jalambert98/WCSA_SDP_2022/Hardware/WCSA_OrCAD/WCSA_SystemSchem/README.txt

Copy/paste contents of "/Footprints" folder (but not folder itself)
into --> "C:\Cadence\SPB_17.4\share\pcb\pcb_lib\symbols"

AND / OR

Add the complete filepath of the "/Footprints" folder into the
'psmpath' variable within Allegro's user preferences
