jalambert98/WCSA_SDP_2022/Hardware/WCSA_OrCAD/JLC_BoardPics/3D-View/3D-04-TopAngleWhole.png

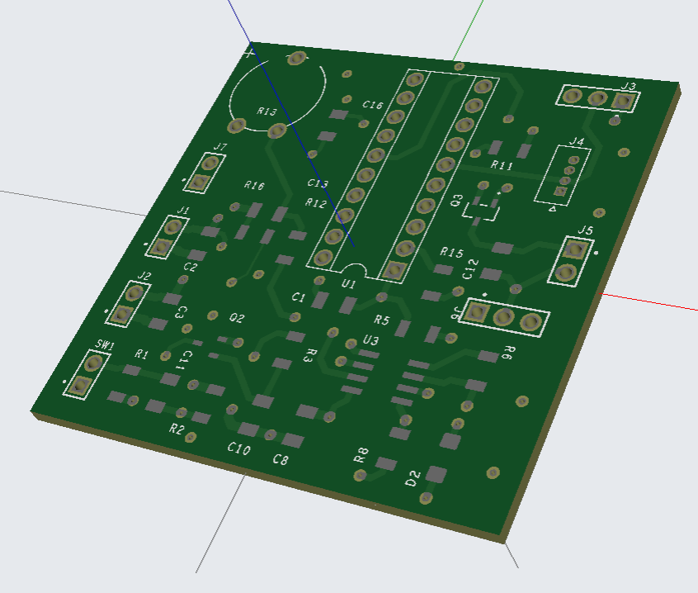
Hardware/WCSA_OrCAD/JLC_BoardPics/3D-View/3D-04-TopAngleWhole.png
