jalambert98/WCSA_SDP_2022/Hardware/WCSA_OrCAD/JLC_BoardPics/LayerView/01-Top_SMSS.png

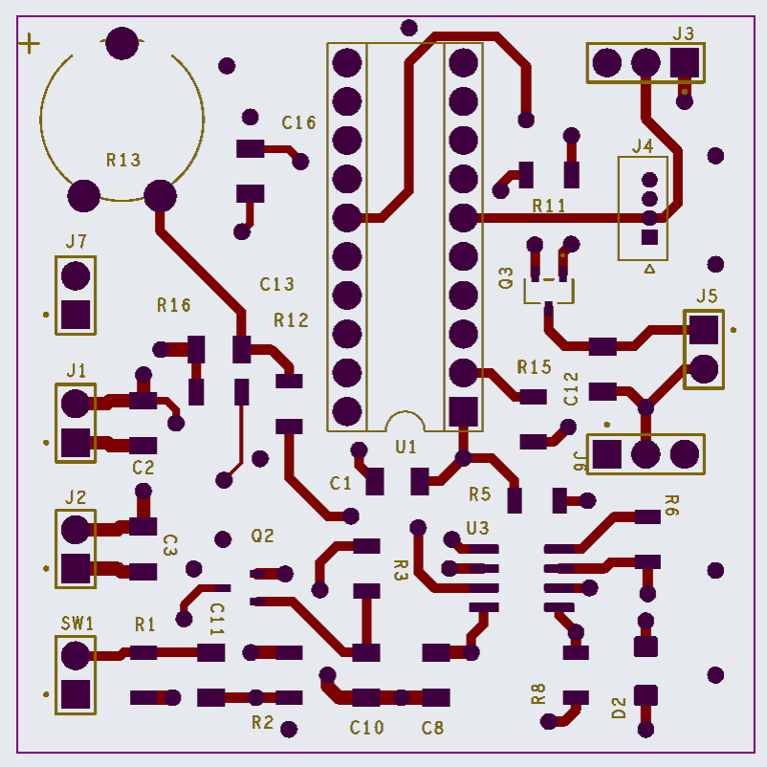
Hardware/WCSA_OrCAD/JLC_BoardPics/LayerView/01-Top_SMSS.png
