jalambert98/WCSA_SDP_2022/Hardware/WCSA_OrCAD/JLC_BoardPics/LayerView/02-GND_In1.png

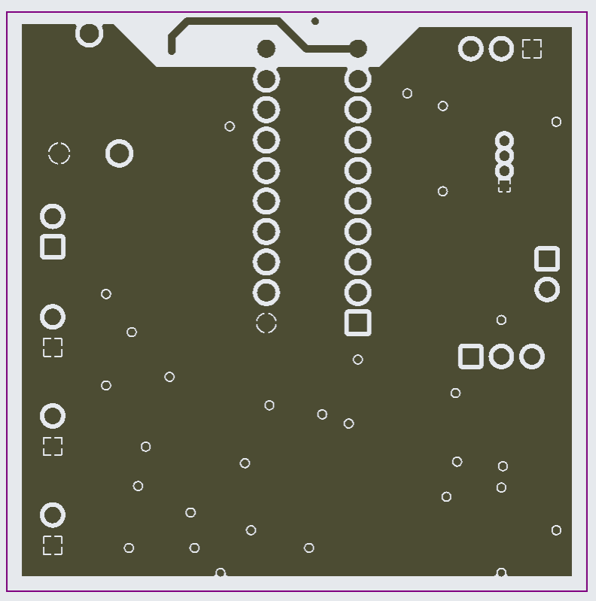
Hardware/WCSA_OrCAD/JLC_BoardPics/LayerView/02-GND_In1.png
