jalambert98/WCSA_SDP_2022/Hardware/WCSA_OrCAD/JLC_BoardPics/LayerView/03-DCV_In2.png

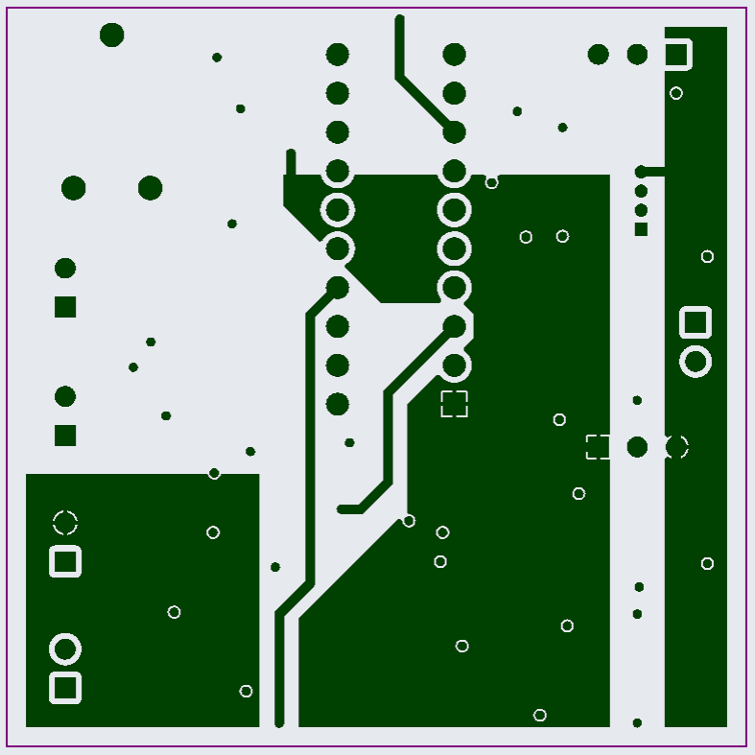
Hardware/WCSA_OrCAD/JLC_BoardPics/LayerView/03-DCV_In2.png
