jalambert98/WCSA_SDP_2022/Hardware/WCSA_OrCAD/JLC_BoardPics/ProductionPCB/LidarHeader_Footprint.jpg

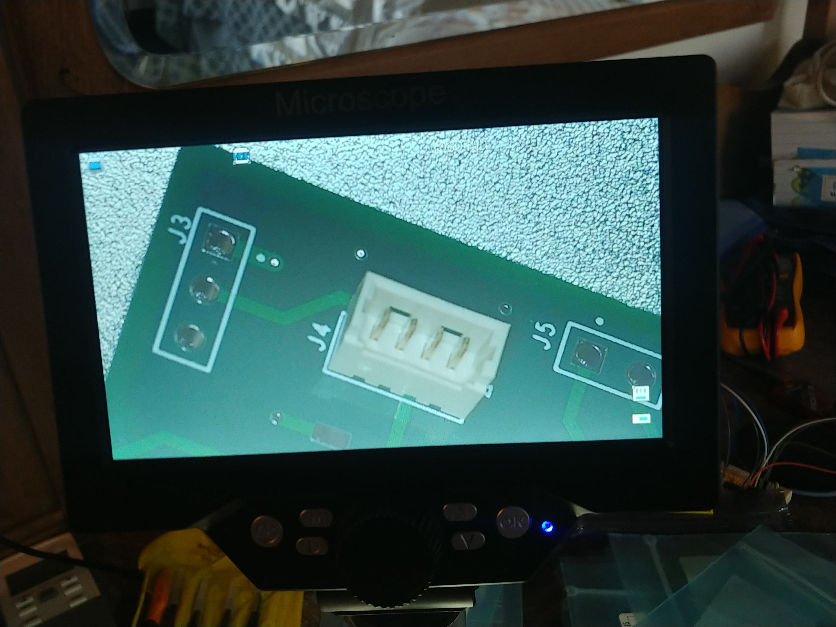
Hardware/WCSA_OrCAD/JLC_BoardPics/ProductionPCB/LidarHeader_Footprint.jpg
