jalambert98/WCSA_SDP_2022/Hardware/WCSA_OrCAD/JLC_BoardPics/ProductionPCB/PMIC_Footprint-Empty.jpg

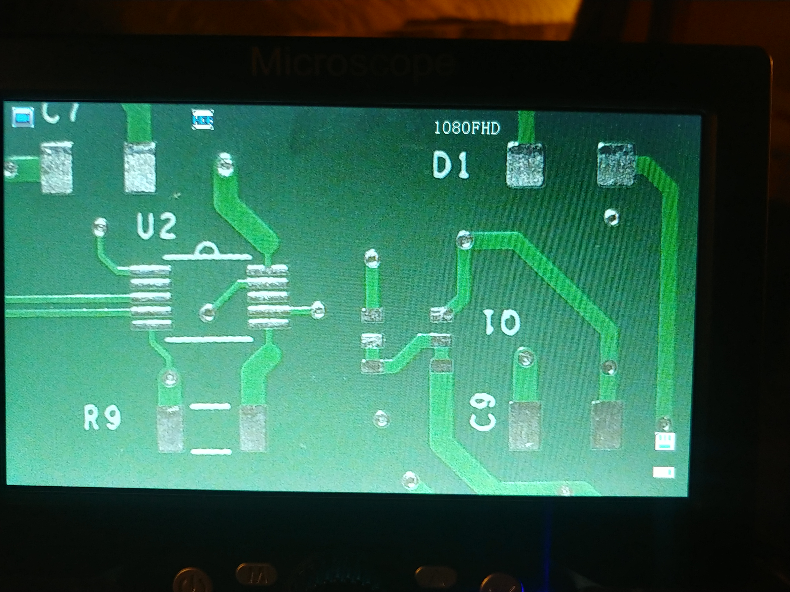
Hardware/WCSA_OrCAD/JLC_BoardPics/ProductionPCB/PMIC_Footprint-Empty.jpg
