jalambert98/WCSA_SDP_2022/Hardware/WCSA_OrCAD/PSPICE/MCU_PowerButton_Simulation/MCU_POWER_BUTTON.png

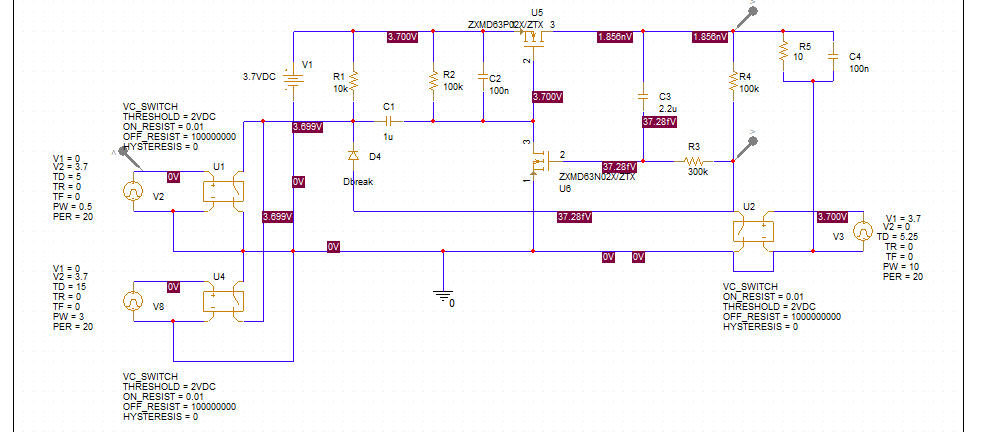
Hardware/WCSA_OrCAD/PSPICE/MCU_PowerButton_Simulation/MCU_POWER_BUTTON.png
