jalambert98/WCSA_SDP_2022/Hardware/WCSA_OrCAD/PSPICE/PowerSystem_Simulations/POWERSYSTEM_SIMULATIONS.png

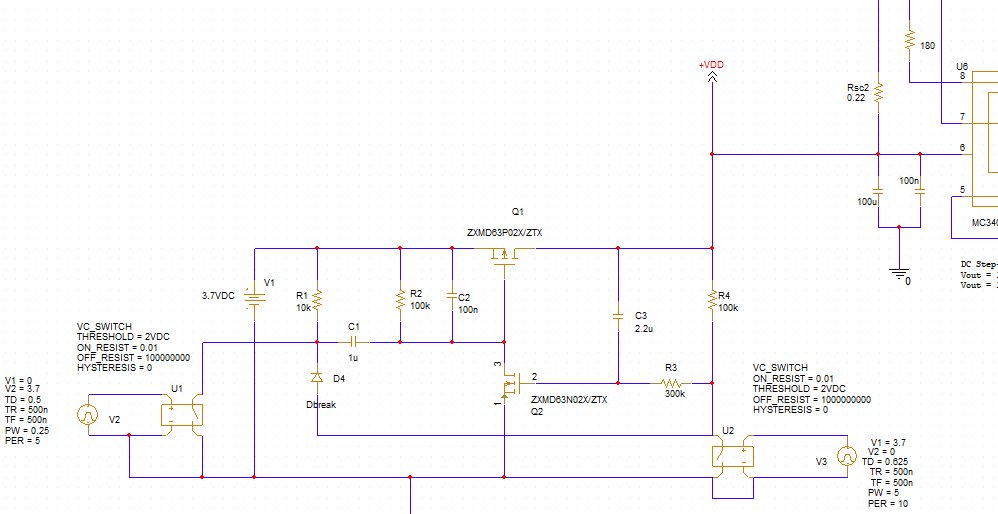
Hardware/WCSA_OrCAD/PSPICE/PowerSystem_Simulations/POWERSYSTEM_SIMULATIONS.png
