jalambert98/WCSA_SDP_2022/Hardware/WCSA_OrCAD/WCSA_SystemSchem/WCSA_SYSTEMSCHEM.png

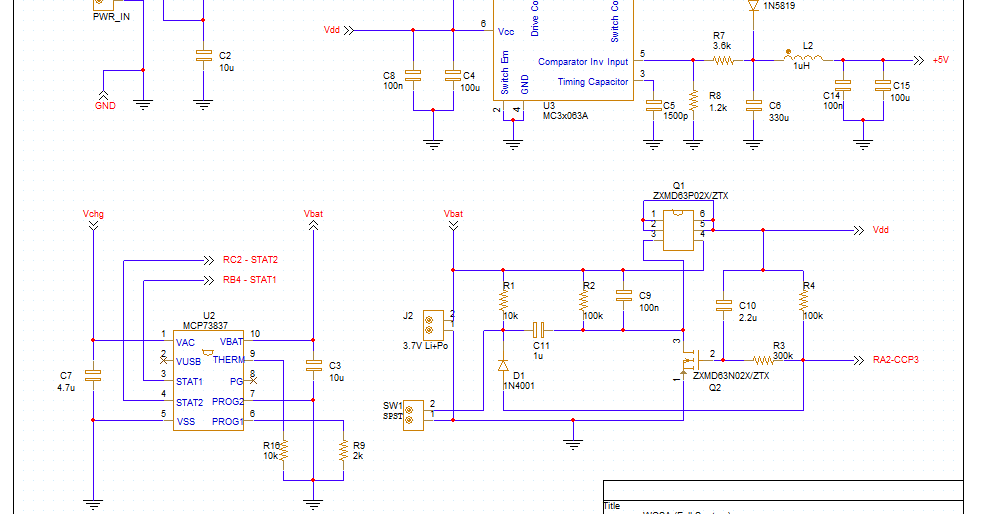
Hardware/WCSA_OrCAD/WCSA_SystemSchem/WCSA_SYSTEMSCHEM.png
