jalambert98/WCSA_SDP_2022/Hardware/SolidWorks_Assembly/CaneWithClamps.SLDASM

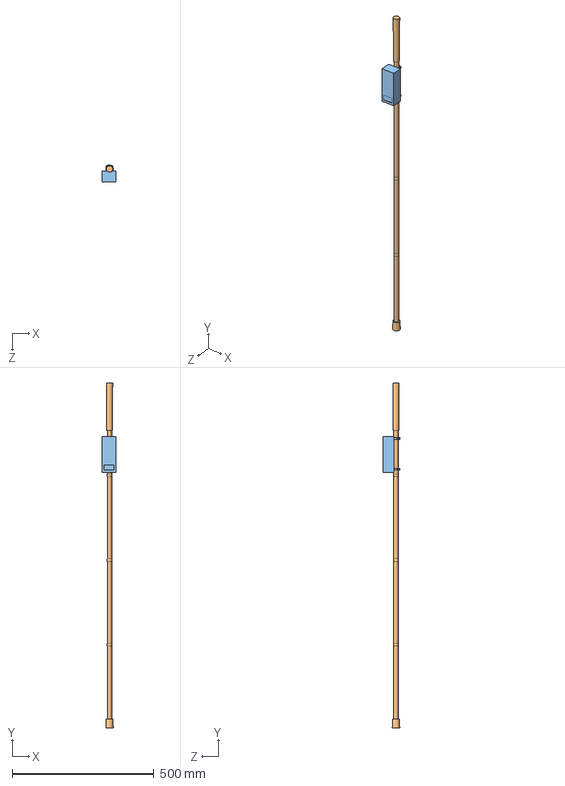
[picture p20: CAD file, 2022-04-21]
Hardware/SolidWorks_Assembly/CaneWithClamps.SLDASM
50.6 x 1216.0 x 59.4 mm
3dCaneRev1.05
HoseClamp x 2
Housing Rev0.5
