jalambert98/WCSA_SDP_2022/Hardware/SolidWorks_Assembly/LidSmSpeaker_V5.0.SLDPRT

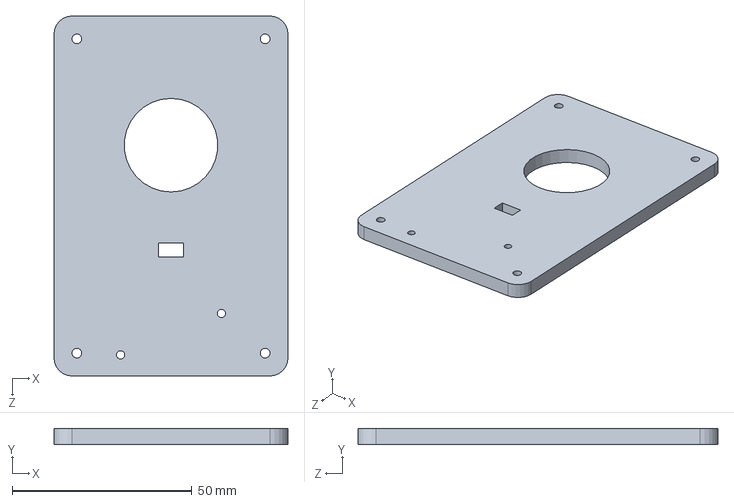
[picture p21: CAD file, 2022-05-31]
Hardware/SolidWorks_Assembly/LidSmSpeaker_V5.0.SLDPRT
65.0 x 4.50 x 100.0 mm
