jalambert98/WCSA_SDP_2022/Hardware/SolidWorks_Assembly/HousingBox_V5.0.SLDPRT

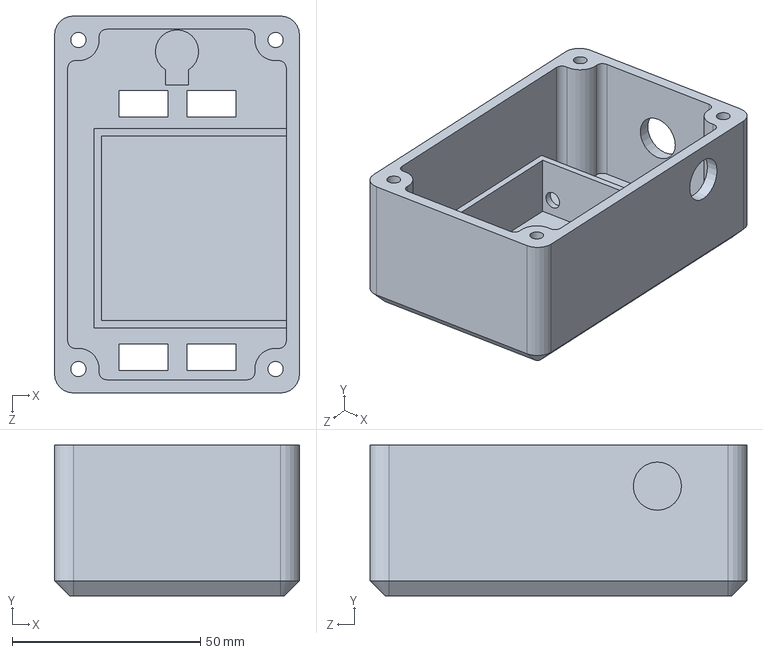
[picture p22: CAD file, 2022-05-31]
Hardware/SolidWorks_Assembly/HousingBox_V5.0.SLDPRT
65.0 x 40.0 x 100.0 mm
