jalambert98/WCSA_SDP_2022/Hardware/SolidWorks_Assembly/HoseClamp.SLDPRT

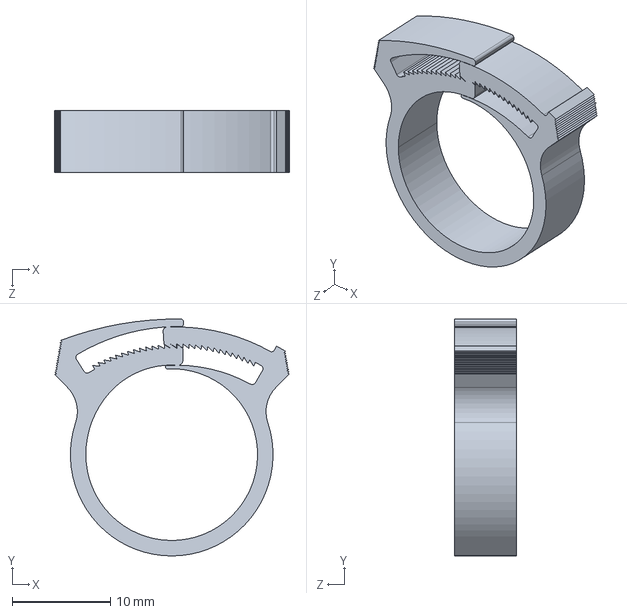
[picture p23: CAD file, 2022-04-21]
Hardware/SolidWorks_Assembly/HoseClamp.SLDPRT
23.9 x 24.1 x 6.35 mm
