jalambert98/WCSA_SDP_2022/Hardware/SolidWorks_Assembly/3dCaneRev1.05.SLDPRT

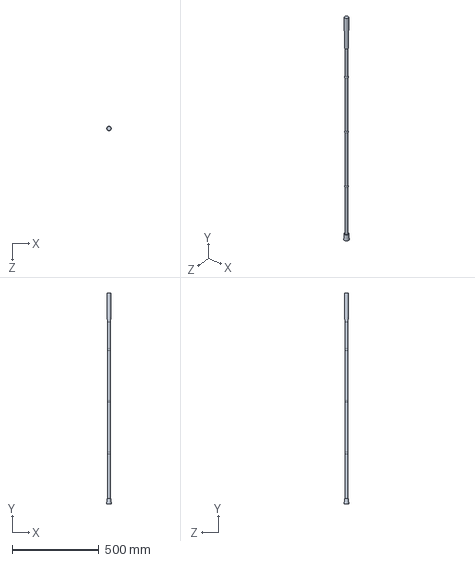
[picture p24: CAD file, 2022-04-21]
Hardware/SolidWorks_Assembly/3dCaneRev1.05.SLDPRT
26.8 x 1216.0 x 26.8 mm
