jalambert98/WCSA_SDP_2022/Hardware/SolidWorks_Assembly/Housing_Rev0.5.SLDPRT

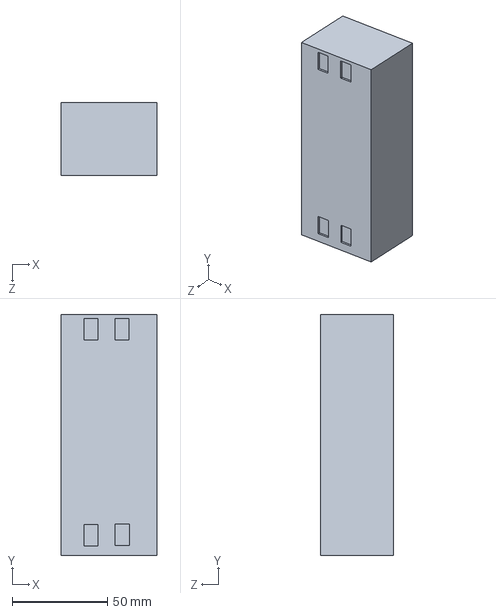
[picture p25: CAD file, 2022-04-21]
Hardware/SolidWorks_Assembly/Housing_Rev0.5.SLDPRT
50.6 x 126.8 x 38.4 mm
