jalambert98/WCSA_SDP_2022/(list of files, cad)

Other CAD files:
Hardware/WCSA_OrCAD/WCSA_SystemSchem/Footprints/capc3216x110n.psm
Hardware/WCSA_OrCAD/WCSA_SystemSchem/Footprints/diosc190x340x116-2n.psm
Hardware/WCSA_OrCAD/WCSA_SystemSchem/Footprints/dip-20-socket.psm
Hardware/WCSA_OrCAD/WCSA_SystemSchem/Footprints/ind_smt_do3316p_12p95x9p4_coc.psm
Hardware/WCSA_OrCAD/WCSA_SystemSchem/Footprints/indc3216x95n.psm
Hardware/WCSA_OrCAD/WCSA_SystemSchem/Footprints/molex_530470410.psm
Hardware/WCSA_OrCAD/WCSA_SystemSchem/Footprints/mub10a-l.psm
Hardware/WCSA_OrCAD/WCSA_SystemSchem/Footprints/mub10a-m.psm
Hardware/WCSA_OrCAD/WCSA_SystemSchem/Footprints/mub10a.psm
Hardware/WCSA_OrCAD/WCSA_SystemSchem/Footprints/resc3116x65n.psm
Hardware/WCSA_OrCAD/WCSA_SystemSchem/Footprints/samtec_mtsw-101-08-s-d-315.psm
Hardware/WCSA_OrCAD/WCSA_SystemSchem/Footprints/samtec_tsw-101-24-g-t.psm
Hardware/WCSA_OrCAD/WCSA_SystemSchem/Footprints/soic127p599x175-8n.psm
Hardware/WCSA_OrCAD/WCSA_SystemSchem/Footprints/sop50p490x110-10n.psm
Hardware/WCSA_OrCAD/WCSA_SystemSchem/Footprints/sot23_2p9x1p3_dio-l.psm
Hardware/WCSA_OrCAD/WCSA_SystemSchem/Footprints/sot23_2p9x1p3_dio-m.psm
Hardware/WCSA_OrCAD/WCSA_SystemSchem/Footprints/sot23_2p9x1p3_dio.psm
Hardware/WCSA_OrCAD/WCSA_SystemSchem/Footprints/to_-102a2020-s_phr.psm
Hardware/WCSA_OrCAD/WCSA_SystemSchem/Footprints/zxm62p02e6ta_dio-l.psm
Hardware/WCSA_OrCAD/WCSA_SystemSchem/Footprints/zxm62p02e6ta_dio-m.psm
Hardware/WCSA_OrCAD/WCSA_SystemSchem/Footprints/zxm62p02e6ta_dio.psm
