jalambert98/WCSA_SDP_2022/Hardware/WCSA_OrCAD/Schematic PDFs/MCUcomms_WCSA.pdf

UART Monitoring | LiDAR Sensor

## Microcontroller

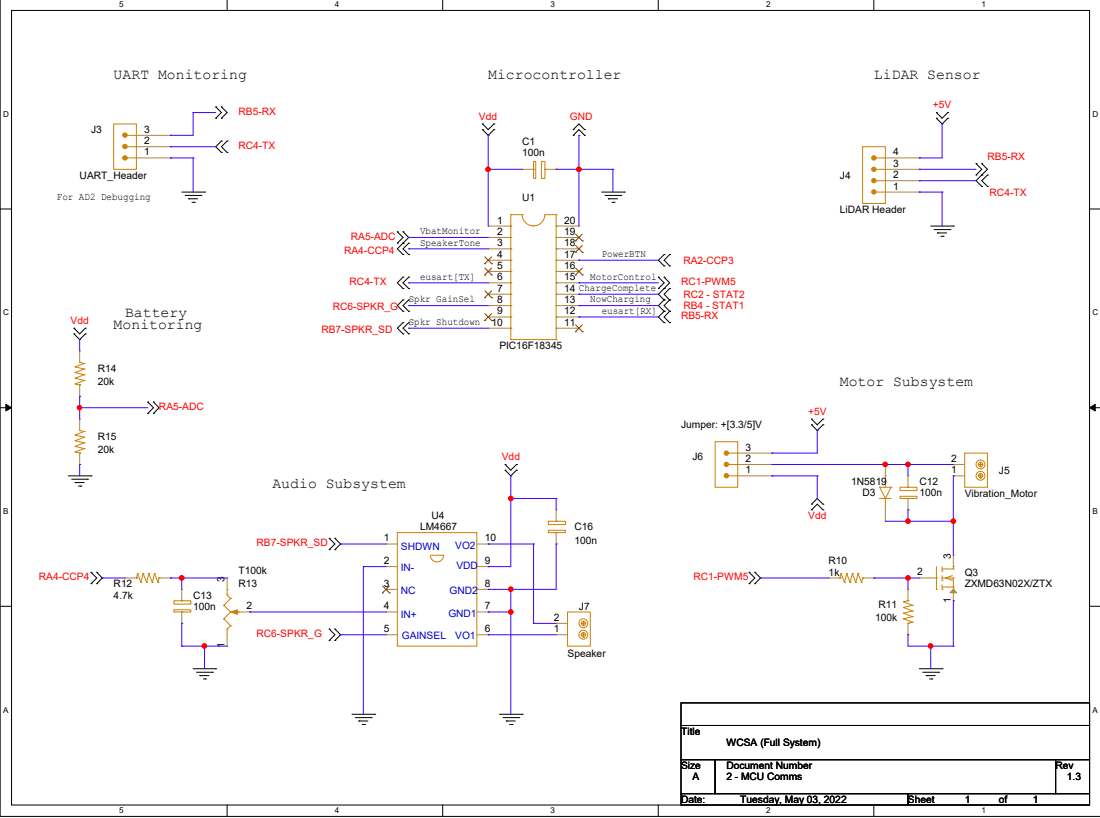
[picture p26: page 1]
