jalambert98/WCSA_SDP_2022/Hardware/WCSA_OrCAD/Schematic PDFs/PowerSubsystem_WCSA.pdf

## Charging Input

## +5VDC Voltage Regulation

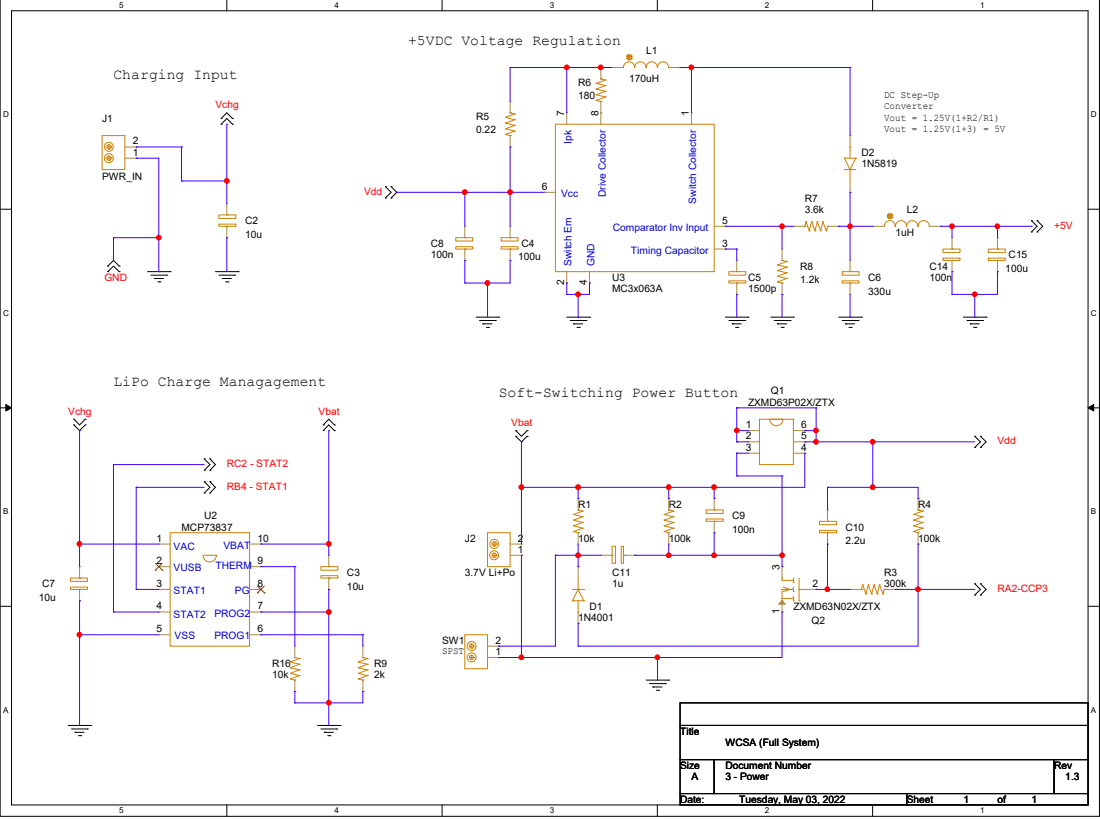
[picture p27: page 1]

Soft-Switching Power Button
