jalambert98/WCSA_SDP_2022/Hardware/WCSA_OrCAD/Schematic PDFs/PSPICE_Testing_PowerSubsystem_WCSA.pdf

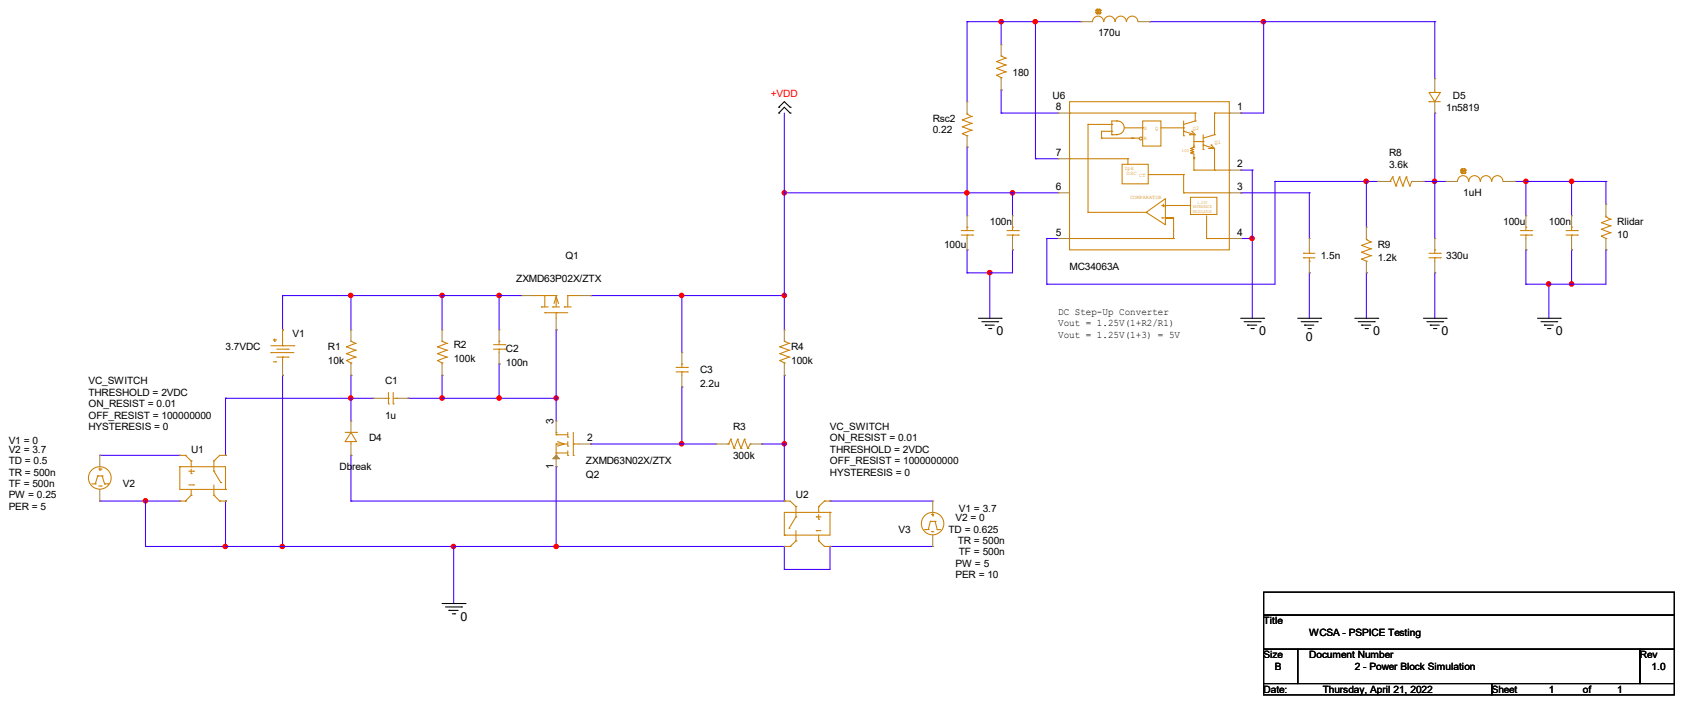
[picture p28: page 1]

DC Step-Up Converter
Vout = 1.25V(1+R2/R1)
Vout = 1.25V(1+3) = 5V
