jalambert98/WCSA_SDP_2022/(list of files, drawings)

Other design files:
Hardware/WCSA_OrCAD/PSPICE/MCU_PowerButton_Simulation/MCU_POWER_BUTTON.DSN
Hardware/WCSA_OrCAD/PSPICE/MCU_PowerButton_Simulation/MCU_Power_Button.opj
Hardware/WCSA_OrCAD/PSPICE/PowerSystem_Simulations/PowerSystem_Simulations-PSpiceFiles/SCHEMATIC1/PowerBlock_Sim/SLLM359/MC33063A-Q1_PSPICE_TRANS/MC33063A-Q1_TRANS.OPJ
Hardware/WCSA_OrCAD/PSPICE/PowerSystem_Simulations/PowerSystem_Simulations-PSpiceFiles/SCHEMATIC1/PowerBlock_Sim/SLLM359/MC33063A-Q1_PSPICE_TRANS/MC33063A-Q1D_TRANS.OLB
Hardware/WCSA_OrCAD/PSPICE/PowerSystem_Simulations/POWERSYSTEM_SIMULATIONS.DSN
Hardware/WCSA_OrCAD/PSPICE/PowerSystem_Simulations/PowerSystem_Simulations.opj
Hardware/WCSA_OrCAD/WCSA_SystemSchem/WCSA_SYSTEMSCHEM.DSN
Hardware/WCSA_OrCAD/WCSA_SystemSchem/WCSA_SystemSchem.opj
