jalambert98/WCSA_SDP_2022/Current Software Release/curr_src/Lidar_Sensor.c

/* 
 * File:    Lidar_Sensor.c
 * Author:  Jack Lambert     <joalambe@ucsc.edu>
 * Project: WCSA_SDP_2022
 *
 * Created on March 4th, 2022 at 8:25PM
 */
//------------------------------------------------------------------------------

#include "Lidar_Sensor.h"
#include "eusart.h"
#include "pin_manager.h"


//==============================================================================
//-------------------------------- #DEFINES ------------------------------------
//==============================================================================

// #define LIDAR_SENSOR_TEST


//==============================================================================
//---------------------------- STATIC VARIABLES --------------------------------
//==============================================================================

static volatile Lidar_MsgRX_t currMsg;
static volatile Lidar_StateRX_t currState;
static volatile uint8_t msgIndex;


//==============================================================================
//------------------------------ PUBLIC LIBRARY --------------------------------
//==============================================================================

void Lidar_Sensor_Init(void) {
    // Set RX State Machine to IDLE state
    currState = IDLE;

    // Initialize all MsgRX variables to zero
    uint8_t i;
    for (i = 0; i < LIDAR_RX_MSG_LEN; i++) {
        currMsg.data[i] = 0;
    }
    currMsg.distance = 0;
    currMsg.strength = 0;
    currMsg.temp = 0;
    currMsg.checksum = 0;
    msgIndex = 0;
}

//------------------------------------------------------------------------------

void Lidar_Sensor_UpdateChecksum(void) {
    uint8_t i;
    currMsg.checksum = 0;

    for (i = 0; i < (LIDAR_RX_MSG_LEN - 1); i++) {
        currMsg.checksum += currMsg.data[i];
    }

    return;
}

//------------------------------------------------------------------------------

void Lidar_Sensor_RXSM(uint8_t ch) {
    switch (currState) {
        case IDLE: // index[0]
            if (ch == LIDAR_RX_FRAMEHEADER) {
                currMsg.data[msgIndex] = ch;
                currState = W4_HEADER_2;
                msgIndex++; // --> [1]
            }
            // otherwise, do nothing (remain in IDLE)
            break;

        case W4_HEADER_2: // index[1]
            if (ch == LIDAR_RX_FRAMEHEADER) {
                currMsg.data[msgIndex] = ch;
                currState = W4_DIST_L;
                msgIndex++; // --> [2]
            } else {
                // Reset RX State Machine if incorrect header byte
                currState = IDLE;
                msgIndex = 0;
            }
            break;

        case W4_DIST_L: // index[2]
            currMsg.data[msgIndex] = ch;
            currState = W4_DIST_H;
            msgIndex++; // --> [3]
            break;

        case W4_DIST_H: // index[3]
            currMsg.data[msgIndex] = ch;
            currState = W4_STRENGTH_L;
            msgIndex++; // --> [4]
            break;

        case W4_STRENGTH_L: // index[4]
            currMsg.data[msgIndex] = ch;
            currState = W4_STRENGTH_H;
            msgIndex++; // --> [5]
            break;

        case W4_STRENGTH_H: // index[5]
            currMsg.data[msgIndex] = ch;
            currState = W4_TEMP_L;
            msgIndex++; // --> [6]
            break;

        case W4_TEMP_L: // index[6]
            currMsg.data[msgIndex] = ch;
            currState = W4_TEMP_H;
            msgIndex++; // --> [7]
            break;

        case W4_TEMP_H: // index[7]
            currMsg.data[msgIndex] = ch;
            currState = W4_CHECKSUM;
            msgIndex++; // --> [8]
            break;

        case W4_CHECKSUM: // index[8]
            currMsg.data[msgIndex] = ch;
            currState = IDLE;
            msgIndex = 0;
            Lidar_Sensor_UpdateChecksum();

            if (ch == currMsg.checksum) {
                // Received message is valid, so update struct variables
                currMsg.distance = (uint16_t) (currMsg.data[INDEX_DIST_H] << BYTE_SIZE)
                        + currMsg.data[INDEX_DIST_L];

                currMsg.strength = (uint16_t) (currMsg.data[INDEX_STRENGTH_H] << BYTE_SIZE)
                        + currMsg.data[INDEX_STRENGTH_L];

                currMsg.temp = ((uint16_t) (currMsg.data[INDEX_TEMP_H] << BYTE_SIZE)
                        + currMsg.data[INDEX_TEMP_L]);
                currMsg.temp = (currMsg.temp >> 3) - 256;

                // should trigger some kind of "data ready" event here
            }
            break;
    }
    return;
}

//------------------------------------------------------------------------------

uint16_t Lidar_Sensor_GetDistance(void) {
    return currMsg.distance;
}

//------------------------------------------------------------------------------

uint16_t Lidar_Sensor_GetStrength(void) {
    return currMsg.strength;
}

//------------------------------------------------------------------------------

uint16_t Lidar_Sensor_GetTemp(void) {
    return currMsg.temp;
}

//------------------------------------------------------------------------------

void Lidar_Sensor_SetFrameRate(uint16_t frameRate) {
    // Separate 16-bit FrameRate into high & low bytes
    uint8_t frameRateL = (uint8_t) (frameRate & 0x00FF);
    uint8_t frameRateH = (uint8_t) ((frameRate & 0xFF00) >> BYTE_SIZE);

    // Assemble message to send to Lidar Sensor
    uint8_t msg[FRAMERATE_MSG_LEN];
    msg[0] = LIDAR_TX_HEAD;
    msg[1] = FRAMERATE_MSG_LEN;
    msg[2] = FRAMERATE_MSG_ID;
    msg[3] = frameRateL;
    msg[4] = frameRateH;

    // Calculate checksum (last byte of msg)
    uint8_t cksum = 0;
    uint8_t i;
    for (i = 0; i < (FRAMERATE_MSG_LEN - 1); i++) {
        cksum += msg[i];
    }
    msg[5] = cksum;
    
    // Send framerate message to sensor
    for (i = 0; i< FRAMERATE_MSG_LEN; i++) {
        EUSART_Write(msg[i]);
    }
    
    // Send SAVE_SETTINGS message to sensor
    Lidar_Sensor_SaveSettings();
    return;
}

//------------------------------------------------------------------------------

void Lidar_Sensor_Trig(void) {
    // Assemble message
    uint8_t msg[TRIG_MSG_LEN] = {LIDAR_TX_HEAD, 
                                 TRIG_MSG_LEN, 
                                 TRIG_MSG_ID, 
                                 TRIG_MSG_CKSUM};
    // Send message
    uint8_t i;
    for (i = 0; i < TRIG_MSG_LEN; i++) {
        EUSART_Write(msg[i]);
    }
}

//------------------------------------------------------------------------------

void Lidar_Sensor_SetOutput_cm(void) {
    // Assemble message
    uint8_t msg[SETOUT_MSG_LEN] = {LIDAR_TX_HEAD,
                                   SETOUT_MSG_LEN,
                                   SETOUT_MSG_ID,
                                   SETOUT_CM_DATA,
                                   SETOUT_CM_CKSUM};
    // Send message
    uint8_t i;
    for (i = 0; i < SETOUT_MSG_LEN; i++) {
        EUSART_Write(msg[i]);
    }
    
    // Save new settings
    Lidar_Sensor_SaveSettings();
}

//------------------------------------------------------------------------------

void Lidar_Sensor_SetOutput_mm(void) {
    // Assemble message
    uint8_t msg[SETOUT_MSG_LEN] = {LIDAR_TX_HEAD,
                                   SETOUT_MSG_LEN,
                                   SETOUT_MSG_ID,
                                   SETOUT_MM_DATA,
                                   SETOUT_MM_CKSUM};
    // Send message
    uint8_t i;
    for (i = 0; i < SETOUT_MSG_LEN; i++) {
        EUSART_Write(msg[i]);
    }
    
    // Save new settings
    Lidar_Sensor_SaveSettings();
}

//------------------------------------------------------------------------------

void Lidar_Sensor_SaveSettings(void) {
    // Assemble message
    uint8_t msg[SAVESET_MSG_LEN] = {LIDAR_TX_HEAD, 
                                    SAVESET_MSG_LEN, 
                                    SAVESET_MSG_ID, 
                                    SAVESET_MSG_CKSUM};
    // Send message
    uint8_t i;
    for (i = 0; i < SAVESET_MSG_LEN; i++) {
        EUSART_Write(msg[i]);
    }
}

//------------------------------------------------------------------------------

#ifdef LIDAR_SENSOR_TEST

#include "WCSA_system.h"
#include "FRT.h"

//===============================//
//#define LIDAR_AUTO_READ_TEST
#define LIDAR_MANUAL_READ_TEST
//#define LIDAR_TX_UPDATE
//===============================//

#ifdef LIDAR_AUTO_READ_TEST
#define SAMPLE_RATE         10  // 10ms --> 100Hz

/*
 * Assumes that:
 * Lidar_Sensor_SetFrameRate(fr) 
 * has already been called for (fr > 0)
 */
int main(void) {
    PIC16_Init();
    Lidar_Sensor_Init();
    FRT_Init();
    
    //--- Initial Print Statement ---//
    printf("//=== Lidar_Sensor.c ===//\n");
    printf("LIDAR_AUTO_READ_TEST - Last compiled on %s at %s\n\n", __DATE__, __TIME__);
    
    uint32_t currMilli = FRT_GetMillis();
    uint32_t prevMilli = currMilli;

    while (1) {
        /*
         * NOTE:    WDT will force a reset if not cleared 
         *          within every 2 sec or less
         */
        RESET_WDT();  // reset watchdog timer at start of each loop
        
        currMilli = FRT_GetMillis();    // update free-running timer
        
        if ((currMilli - prevMilli) >= SAMPLE_RATE) {
            
            //printf("Dist = %u[cm]\n", Lidar_Sensor_GetDistance());
            //printf("Strength = %u\n", Lidar_Sensor_GetStrength());
            //printf("Temp = %u[degC]\n\n", Lidar_Sensor_GetTemp());
            
            printf("%u\n", Lidar_Sensor_GetDistance());
        }
    }

    while (1);
    return 0;
}

#endif


#ifdef LIDAR_MANUAL_READ_TEST
#define SAMPLE_RATE         10000  // 10000us --> 100Hz

/*
 * Assumes that: Lidar_Sensor_SetFrameRate(0)
 * has already been called (manual trigger mode)
 */
int main(void) {
    PIC16_Init();
    FRT_Init();
    Lidar_Sensor_Init();
    
    printf("\n//=== Lidar_Sensor.c ===//\n");
    printf("LIDAR_MANUAL_READ_TEST - Last compiled on %s at %s\n\n", __DATE__, __TIME__);
    
    Lidar_Sensor_Trig();
    unsigned long currMicro = FRT_GetMicros();
    unsigned long prevMicro = currMicro;
    uint16_t dist = 0;

    while (1) {
        /*
         * NOTE:    WDT will force a reset if not cleared 
         *          within every 2 sec or less
         */
        RESET_WDT();
        
        currMicro = FRT_GetMicros();    // update free-running timer
        
        if ((currMicro - prevMicro) >= SAMPLE_RATE) {
            /*
            printf("Dist     = %ucm\n", Lidar_Sensor_GetDistance());
            printf("Strength = %u\n", Lidar_Sensor_GetStrength());
            printf("Temp     = %u\n\n", Lidar_Sensor_GetTemp());
             */
            
            RESET_WDT();
            dist = Lidar_Sensor_GetDistance();
            printf("\nREADING: %u\n", dist);
            
            Lidar_Sensor_Trig();
            prevMicro = currMicro;
        }
    }
}
#endif


#ifdef LIDAR_TX_UPDATE

int main(void) {
    PIC16_Init();
    Lidar_Sensor_Init();
    Lidar_Sensor_SetFrameRate(0);
    Lidar_Sensor_SetOutput_mm();
    
    while(1);
    return 0;
}

#endif


#endif
