jalambert98/WCSA_SDP_2022/Current Software Release/curr_src/device_config.c

/* 
 * File:    device_config.c
 * Author:  Jack Lambert     <joalambe@ucsc.edu>
 * Project: WCSA_SDP_2022
 *
 * NOTE: Generated originally by Microchip Code Configurator (MCC) and then
 *       further modified by Jack Lambert
 * 
 * Created on February 8, 2022, 2:15 PM
 */
//------------------------------------------------------------------------------

// CONFIG1
#pragma config FEXTOSC = OFF    // FEXTOSC External Oscillator mode Selection bits->Oscillator not enabled
#pragma config RSTOSC = HFINT32    // Power-up default value for COSC bits->HFINTOSC with 2x PLL (32MHz)
#pragma config CLKOUTEN = OFF    // Clock Out Enable bit->CLKOUT function is disabled; I/O or oscillator function on OSC2
#pragma config CSWEN = ON    // Clock Switch Enable bit->Writing to NOSC and NDIV is allowed
#pragma config FCMEN = ON    // Fail-Safe Clock Monitor Enable->Fail-Safe Clock Monitor is disabled

// CONFIG2
#pragma config MCLRE = ON    // Master Clear Enable bit->MCLR/VPP pin function is MCLR; Weak pull-up enabled
#pragma config PWRTE = OFF    // Power-up Timer Enable bit->PWRT disabled
#pragma config WDTE = ON    // Watchdog Timer Enable bits->WDT enabled, SWDTEN is ignored
#pragma config LPBOREN = OFF    // Low-power BOR enable bit->ULPBOR disabled
#pragma config BOREN = ON    // Brown-out Reset Enable bits->Brown-out Reset enabled, SBOREN bit ignored
#pragma config BORV = HIGH    // Brown-out Reset Voltage selection bit->Brown-out voltage (Vbor) set to 2.7V
#pragma config PPS1WAY = OFF    // PPSLOCK bit One-Way Set Enable bit->The PPSLOCK bit can be cleared and set only once; PPS registers remain locked after one clear/set cycle
#pragma config STVREN = ON    // Stack Overflow/Underflow Reset Enable bit->Stack Overflow or Underflow will cause a Reset
#pragma config DEBUG = OFF    // Debugger enable bit->Background debugger disabled

// CONFIG3
#pragma config WRT = OFF    // User NVM self-write protection bits->Write protection off
#pragma config LVP = ON    // Low Voltage Programming Enable bit->Low Voltage programming enabled. MCLR/VPP pin function is MCLR. MCLRE configuration bit is ignored.

// CONFIG4
#pragma config CP = OFF    // User NVM Program Memory Code Protection bit->User NVM code protection disabled
#pragma config CPD = OFF    // Data NVM Memory Code Protection bit->Data NVM code protection disabled
