jalambert98/WCSA_SDP_2022/Current Software Release/curr_src/interrupt_manager.h

/* 
 * File:    interrupt_manager.h
 * Author:  Jack Lambert     <joalambe@ucsc.edu>
 * Project: WCSA_SDP_2022
 *
 * NOTE: Generated originally by Microchip Code Configurator (MCC) and then
 *       further modified by Jack Lambert
 * 
 * Created on February 8, 2022, 2:15 PM
 */
//------------------------------------------------------------------------------

#ifndef INTERRUPT_MANAGER_H
#define INTERRUPT_MANAGER_H

//------------------------------------------------------------------------------
/**
 * @Param
    none
 * @Returns
    none
 * @Description
    This macro will enable global interrupts.
 * @Example
    INTERRUPT_GlobalInterruptEnable();
 */
#define INTERRUPT_GlobalInterruptEnable() (INTCONbits.GIE = 1)

//------------------------------------------------------------------------------
/**
 * @Param
    none
 * @Returns
    none
 * @Description
    This macro will disable global interrupts.
 * @Example
    INTERRUPT_GlobalInterruptDisable();
 */
#define INTERRUPT_GlobalInterruptDisable() (INTCONbits.GIE = 0)

//------------------------------------------------------------------------------
/**
 * @Param
    none
 * @Returns
    none
 * @Description
    This macro will enable peripheral interrupts.
 * @Example
    INTERRUPT_PeripheralInterruptEnable();
 */
#define INTERRUPT_PeripheralInterruptEnable() (INTCONbits.PEIE = 1)

//------------------------------------------------------------------------------
/**
 * @Param
    none
 * @Returns
    none
 * @Description
    This macro will disable peripheral interrupts.
 * @Example
    INTERRUPT_PeripheralInterruptDisable();
 */
#define INTERRUPT_PeripheralInterruptDisable() (INTCONbits.PEIE = 0)

//------------------------------------------------------------------------------

#endif  // INTERRUPT_MANAGER_H

//------------------------------------------------------------------------------
/**
 End of File
*/
