jalambert98/WCSA_SDP_2022/Current Software Release/curr_src/device_config.h

#ifndef DEVICE_CONFIG_H
#define	DEVICE_CONFIG_H

//------------------------------------------------------------------------------

#define _XTAL_FREQ 32000000

//------------------------------------------------------------------------------

#endif	/* DEVICE_CONFIG_H */

//------------------------------------------------------------------------------
/**
 End of File
 */
