jalambert98/WCSA_SDP_2022/src/ccp1.c

/* 
 * File:    ccp1.c
 * Author:  Jack Lambert     <joalambe@ucsc.edu>
 * Project: WCSA_SDP_2022
 *
 * NOTE: Generated originally by Microchip Code Configurator (MCC) and then
 *       further modified by Jack Lambert
 * 
 * Created on January 26, 2022, 12:20 PM
 */
//------------------------------------------------------------------------------

// [CCP1 = pinRC5 (echo)], [TMR1 ticks @1MHz & rolls over after 16-bit range]

#include "ccp1.h"
#include "PIC16Xpress_DevBoard.h"
#include "JSN_Sensor.h"

//==============================================================================
//---------------------------- STATICS VARIABLES -------------------------------
//==============================================================================

static void (*CCP1_CallBack)(uint16_t);
static uint16_t ticksUp, ticksDown;
static JSN_t *sameSens;
static JSN_t *lastTrig;

//==============================================================================
//------------------------------ PUBLIC LIBRARY --------------------------------
//==============================================================================

static void CCP1_DefaultCallBack(uint16_t capturedValue) {
    lastTrig = JSN_GetLastTrig();
    switch (PIC16_ReadPin(lastTrig->echoPin)) {
            // If pin RC5 is high on this ISR, store ticks
        case HIGH:
            ticksUp = capturedValue;
            break;
            // If pin RC5 is low on this ISR, store ticks & calculate highTime
        case LOW:
            ticksDown = capturedValue;

            // TMR1 ticks @1MHz, so {(tDown-tUp) = eHT[us]}
            lastTrig->echoHighTime = (ticksDown - ticksUp);
            break;
    }
}

//------------------------------------------------------------------------------

void CCP1_Initialize(void) {
    TRISCbits.TRISC5 = INPUT;
    
    // Peripheral Pin Select [PPS] Config
    CCP1PPS = 0x15;         //RC5->CCP1:CCP1; 
    
    // CCP1MODE Every edge; CCP1EN enabled; CCP1FMT right_aligned; 
	CCP1CON = 0x83;    
	
	// CCP1CTS0 CCP1 pin; 
	CCP1CAP = 0x00;    
	
	// CCPR1H 0; 
	CCPR1H = 0x00;    
	
	// CCPR1L 0; 
	CCPR1L = 0x00;    
    
    // Set the default call back function for CCP1
    CCP1_SetCallBack(CCP1_DefaultCallBack);

	// Selecting Timer 1
	CCPTMRSbits.C1TSEL = 0x1;
    
    // Clear the CCP1 interrupt flag
    PIR4bits.CCP1IF = 0;

    // Enable the CCP1 interrupt
    PIE4bits.CCP1IE = 1;

}

//------------------------------------------------------------------------------

void CCP1_CaptureISR(void) {
    CCP1_PERIOD_REG_T module;

    // Clear the CCP1 interrupt flag
    PIR4bits.CCP1IF = 0;

    // Copy captured value.
    module.ccpr1l = CCPR1L;
    module.ccpr1h = CCPR1H;

    // Return 16bit captured value
    CCP1_CallBack(module.ccpr1_16Bit);
}

//------------------------------------------------------------------------------

void CCP1_SetCallBack(void (*customCallBack)(uint16_t)) {
    CCP1_CallBack = customCallBack;
}


//==============================================================================
//--------------------------------END OF FILE-----------------------------------
//==============================================================================
