jalambert98/WCSA_SDP_2022/src/pin_manager.h

/* 
 * File:    pin_manager.h
 * Author:  Jack Lambert     <joalambe@ucsc.edu>
 * Project: WCSA_SDP_2022
 *
 * Created on January 26, 2022, 12:35 PM
 */
//------------------------------------------------------------------------------

#ifndef PIN_MANAGER_H
#define PIN_MANAGER_H

#include <xc.h>

#define ANALOG      1
#define DIGITAL     0

#define PULL_UP_ENABLED      1
#define PULL_UP_DISABLED     0

// get/set RA2 procedures
#define RA2_SetHigh()            do { LATAbits.LATA2 = 1; } while(0)
#define RA2_SetLow()             do { LATAbits.LATA2 = 0; } while(0)
#define RA2_Toggle()             do { LATAbits.LATA2 = ~LATAbits.LATA2; } while(0)
#define RA2_GetValue()              PORTAbits.RA2
#define RA2_SetDigitalInput()    do { TRISAbits.TRISA2 = 1; } while(0)
#define RA2_SetDigitalOutput()   do { TRISAbits.TRISA2 = 0; } while(0)
#define RA2_SetPullup()             do { WPUAbits.WPUA2 = 1; } while(0)
#define RA2_ResetPullup()           do { WPUAbits.WPUA2 = 0; } while(0)
#define RA2_SetAnalogMode()         do { ANSELAbits.ANSA2 = 1; } while(0)
#define RA2_SetDigitalMode()        do { ANSELAbits.ANSA2 = 0; } while(0)

// get/set RC3 procedures
#define RC3_SetHigh()            do { LATCbits.LATC3 = 1; } while(0)
#define RC3_SetLow()             do { LATCbits.LATC3 = 0; } while(0)
#define RC3_Toggle()             do { LATCbits.LATC3 = ~LATCbits.LATC3; } while(0)
#define RC3_GetValue()              PORTCbits.RC3
#define RC3_SetDigitalInput()    do { TRISCbits.TRISC3 = 1; } while(0)
#define RC3_SetDigitalOutput()   do { TRISCbits.TRISC3 = 0; } while(0)
#define RC3_SetPullup()             do { WPUCbits.WPUC3 = 1; } while(0)
#define RC3_ResetPullup()           do { WPUCbits.WPUC3 = 0; } while(0)
#define RC3_SetAnalogMode()         do { ANSELCbits.ANSC3 = 1; } while(0)
#define RC3_SetDigitalMode()        do { ANSELCbits.ANSC3 = 0; } while(0)

// get/set RC5 procedures
#define RC5_SetHigh()            do { LATCbits.LATC5 = 1; } while(0)
#define RC5_SetLow()             do { LATCbits.LATC5 = 0; } while(0)
#define RC5_Toggle()             do { LATCbits.LATC5 = ~LATCbits.LATC5; } while(0)
#define RC5_GetValue()              PORTCbits.RC5
#define RC5_SetDigitalInput()    do { TRISCbits.TRISC5 = 1; } while(0)
#define RC5_SetDigitalOutput()   do { TRISCbits.TRISC5 = 0; } while(0)
#define RC5_SetPullup()             do { WPUCbits.WPUC5 = 1; } while(0)
#define RC5_ResetPullup()           do { WPUCbits.WPUC5 = 0; } while(0)
#define RC5_SetAnalogMode()         do { ANSELCbits.ANSC5 = 1; } while(0)
#define RC5_SetDigitalMode()        do { ANSELCbits.ANSC5 = 0; } while(0)


//------------------------------------------------------------------------------
/**
   @Param
    none
   @Returns
    none
   @Description
    GPIO and peripheral I/O initialization
 */
void PIN_MANAGER_Initialize (void);

//------------------------------------------------------------------------------
/**
 * @Param
    none
 * @Returns
    none
 * @Description
    Interrupt on Change Handling routine
 */
void PIN_MANAGER_IOC(void);

//------------------------------------------------------------------------------

#endif // PIN_MANAGER_H


//==============================================================================
//--------------------------------END OF FILE-----------------------------------
//==============================================================================
