jalambert98/WCSA_SDP_2022/src/interrupt_manager.c

/* 
 * File:    interrupt_manager.c
 * Author:  Jack Lambert     <joalambe@ucsc.edu>
 * Project: WCSA_SDP_2022
 *
 * NOTE: Generated originally by Microchip Code Configurator (MCC) and then
 *       further modified by Jack Lambert
 * 
 * Created on January 26, 2022, 12:35 PM
 */
//------------------------------------------------------------------------------

#include "PIC16Xpress_DevBoard.h"
#include "interrupt_manager.h"
#include "Lidar_Sensor.h"
#include "tmr0.h"
#include "eusart.h"
#include "i2c1_master.h"
#include "ccp1.h"
#include "ccp2.h"
#include "ccp3.h"
#include "ccp4.h"

//------------------------------------------------------------------------------

void __interrupt() INTERRUPT_InterruptManager (void)
{
    // interrupt handler
    if(PIE0bits.TMR0IE == 1 && PIR0bits.TMR0IF == 1)
    {
        // Increment FRT
        TMR0_ISR();
    }
    else if(INTCONbits.PEIE == 1)
    {
        if(PIE1bits.RCIE == 1 && PIR1bits.RCIF == 1)
        {
            // Add RX Char from EUSART to Lidar State Machine
            EUSART_RxDefaultInterruptHandler();
            Lidar_Sensor_RXSM(EUSART_Read());
        } 
        else if(PIE1bits.TXIE == 1 && PIR1bits.TXIF == 1)
        {
            // printf triggers this to send serial data from TX pin
            EUSART_TxDefaultInterruptHandler();
        } 
        else if(PIE1bits.SSP1IE == 1 && PIR1bits.SSP1IF == 1)
        {
            // I2C handler for VCSEL
            MSSP1_InterruptHandler();
        } 
        else if(PIE4bits.CCP1IE == 1 && PIR4bits.CCP1IF == 1)
        {
            // Input Capture routine for ECHO1
            CCP1_CaptureISR();
        } 
        else if(PIE4bits.CCP2IE == 1 && PIR4bits.CCP2IF == 1)
        {
            // Input Capture routine for ECHO2
            CCP2_CaptureISR();
        } 
        else if(PIE4bits.CCP3IE == 1 && PIR4bits.CCP3IF == 1)
        {
            // Input Capture routine for ECHO3
            CCP3_CaptureISR();
        } 
        else if(PIE4bits.CCP4IE == 1 && PIR4bits.CCP4IF == 1)
        {
            // Output Compare routine for SpeakerTone frequency
            CCP4_CompareISR();
        } 
        else
        {
            //Unhandled Interrupt
        }
    }      
    else
    {
        //Unhandled Interrupt
    }
}


//==============================================================================
//--------------------------------END OF FILE-----------------------------------
//==============================================================================
