jalambert98/WCSA_SDP_2022/src/device_config.h

/**
  @Generated PIC10 / PIC12 / PIC16 / PIC18 MCUs Source File

  @Company:
    Microchip Technology Inc.

  @File Name:
    device_config.h

  @Summary:
    This is the device_config.h file generated using PIC10 / PIC12 / PIC16 / PIC18 MCUs

  @Description:
    Generation Information :
        Product Revision  :  PIC10 / PIC12 / PIC16 / PIC18 MCUs - 1.81.7
        Device            :  PIC16F18345
        Driver Version    :  2.00
    The generated drivers are tested against the following:
        Compiler          :  XC8 2.31 and above or later
        MPLAB             :  MPLAB X 5.45
*/

#ifndef DEVICE_CONFIG_H
#define	DEVICE_CONFIG_H

#define _XTAL_FREQ 16000000

#endif	/* DEVICE_CONFIG_H */


//==============================================================================
//--------------------------------END OF FILE-----------------------------------
//==============================================================================
