jalambert98/WCSA_SDP_2022/(commit log)

2022-01-15 Initial sketch of JSN library
    Initial sketch utilizes external interrupt pins - which may cause timing issues. Planning to use a single Input Capture Pin (ICP) with a multiplexed output from the 3 JSN sensors. Next upload will reflect input capture system.
2022-01-15 Upload V2 (Jan14,2022 - 6:55PM)
    Compiles fine, but input capture & hardware timers are not yet properly configured
2022-01-16 Finally working with both systems!!
    Have not yet verified accuracy of reported distance values, but have verified that distance values increase/decrease appropriately according to readings from ultrasonic sensor
2022-01-16 Working w 3 sensors
    Using EXTERNAL_INTERRUPTS at a low sample rate, there are no issues reading from 3 separate sensors independently.
    Sensor readings must still be properly translated to a mm distance from ToF conversion
2022-01-17 Working test sketch
    This sketch uses [3x] ultrasonic sensors simultaneously. JSN_Sensor class is configured to EXTERNAL_INTERRUPTS mode. All 3 sensors work accurately.
2022-01-17 Fixed input capture ISR
    Fixed the lack of distance calculation in the input capture ISR, added noise canceler to ICP1, fixed lingering magic numbers, and properly disabled global interrupts before attempting to read 16-bit ICR1 register.
2022-01-17 Updated for input capture test
    Revised test sketch utilizes a single ping sensor on the ICP1 pin and is able to accurately report (via Serial.print statements) distance measurements at 100Hz.
2022-01-17 Updated repo organization so that arduino sketches can run & compile on local machine using identical deployed clone of github repo
2022-01-25 Fixed overloaded PinName_t enum names
    [JSN_Sensor.c]
2022-01-26 Configured ISR to handle TMR0 freerunning timer
2022-01-27 FINALLY configured CPUclk & TMR0 as expected. FR_Timer.c contains a test main which blinks an output pin at 1Hz. Stopwatch confirms accurate
2022-01-27 Fixed TMR0 rollover problem - FR_Timer library now 100% working as expected!
    [tmr0.c, tmr0.h]
2022-01-27 Fixed comments & documentation
    [device_config.c, device_config.h, mcc.c, mcc.h, tmr0.c, tmr0.h]
2022-01-28 Timers are working as expected, but input capture is not properly updating echoHighTime variable (remains fixed at 0x00000000)
    [JSN_Sensor.c, JSN_Sensor.h, ccp1.c, tmr1.c, tmr1.h]
2022-01-28 STILL not working, even with MCC configured hardware
    [JSN_Sensor.c, ccp1.c, ccp1.h, ccp2.c, ccp2.h, ccp3.c, ccp3.h, device_config.c]
2022-01-30 FINALLY got input capture workinggit add WCSA_SDP_2022.X Peripheral interrupt enable bit was never set, so only TMR0 ISR was being called previously. Now all ISRs are working as expected!
2022-01-30 Fixed CCP callbacks to maintain sensor ref until echo pulse completes - fixes some bugs caused by overlapping echo/trig signals at HF. Also modified JSN_Test to support 2 sensors & confirmed proper b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
    [JSN_Sensor.c, ccp1.c, ccp2.c, ccp3.c, tmr1.c]
2022-02-08 Created library skeletons for MotorControl and SpeakerTone modules
2022-02-08 Added skeleton peripheral libraries for CCP4, PWM5, TMR2, TMR3, and made necessary modifications to mcc, interrupt_manager, pin_manager, etc.
2022-02-09 Re-enabled necessary peripherals from PMD reg. ISR now runs, but CCP4 pin does not auto-toggle.
2022-02-10 Fixed FRT_GetMicros callback bug & implemented tentative MotorControl library functions
    [FRT.c, MotorControl.c, MotorControl.h, pin_manager.c, pwm5.c, tmr0.c, tmr0.h, tmr3.c]
2022-02-10 Cleared unnecessary functions from TMR1 library (ISR only needs to reset timer), so no callbacks required
    [tmr1.c, tmr1.h]
2022-02-11 Updated + added comments to SpeakerTone library. Confirmed 100% working with amplifier+speaker circuit. Windows startup melody achieved
2022-02-11 Confirmed MotorControl library also 100% working
2022-02-11 Updated MotorControl_SetIntensity() to accept [0, 1000] range (0.1% resolution) rather than 1% resolution
2022-02-15 Updated JSN_Sensor test to support 3 sensors simultaneously
2022-02-17 Updated JSN_Sensor test main to modularize number of sensors
2022-02-17 Fixed bugs associated with updating nextSens based on numSens
    [JSN_Sensor.c]
2022-02-17 One last bug to make it work
    [JSN_Sensor.c]
2022-02-18 Update sensorTest once again - working clean with trilateration setup now
2022-02-21 Updated pre-built (w/makefile) in order to fix remote build errors
    [JSN_Sensor.c, MotorControl.c]
2022-02-21 basic three sensor test
2022-03-07 Fixed peripheral overlap + hardware stack overflow bugs. Now: the mcc lib's PIC16_Init() function only inits TMR0, EUSART1, and SYSTEM stuff. Additional peripherals are initialized and configured wit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
    [JSN_Sensor.c, Lidar_Sensor.c, Lidar_Sensor.h, MotorControl.c, MotorControl.h, SpeakerTone.c, SpeakerTone.h, VCSEL_Sensor.c]
2022-03-10 Starting Lidar RX state machine for data interpretation
2022-03-10 Integrated Lidar RXSM with EUSART interrupts + added init function
2022-03-10 First complete(?) draft of Lidar_Sensor library - nothing has been tested on MCU yet
2022-03-10 Nuked out a quick Lidar_Sensor test harness. Will test right after this push
2022-03-11 Added Lidar TX Message functions
2022-03-11 Three different Lidar test harnesses. Everything 100% working
2022-03-12 Added JSN vs Lidar testing application
2022-03-12 Testing scripts (MATLAB + Python) are working for JSN vs Lidar test data
2022-04-08 Added all OrCAD files (Capture designs, PSpice sims, footprints, etc)
    [C1206C241MGGACAUTO7210.OLB, C1206C241MGGACAUTO7210.STEP, CHARGECONTROLLERSCHEM.DSN, CHARGECONTROLLERSCHEM.opj, D8.step, DIP-20.OLB, DO-204AL_VIS.step, EDI2CAP.CFG]
2022-04-08 Post-meeting OrCAD files update
    [POWERSYSTEM_SIMULATIONS.DSN, PowerSystem_Simulations.opj, WCSA_SYSTEMSCHEM.DSN, WCSA_SystemSchem.opj]
2022-04-14 Update MATLAB + OrCAD
    [D8.step, DO-204AL_VIS.step, EDI2CAP.CFG, MCU_POWER_BUTTON.DSN, MCU_Power_Button.opj, MUB10A.step, POWERSYSTEM_SIMULATIONS.DSN, PowerSystem_Simulations.opj]
2022-04-15 Fixed all netlisting errors relative to PCB footprints. Everything finally migrated into Allegro
    [C1206C241MGGACAUTO7210.OLB, C1206C241MGGACAUTO7210.STEP, CHARGECONTROLLERSCHEM.DSN, CHARGECONTROLLERSCHEM.opj, D8.step, DIP-20.OLB, DO-204AL_VIS.step, EDI2CAP.CFG]
2022-04-15 Added 2-layer & 4-layer .brd files with size constraints outlined by JLCPCB
    [WCSA_SystemSchem.brd, WCSA_SystemSchem_2-Layer.brd, WCSA_SystemSchem_4-Layer.brd]
2022-04-15 Began routing traces for 2-layer PCB layout
    [WCSA_SYSTEMSCHEM.DSN, WCSA_SystemSchem.opj, WCSA_SystemSchem_2-Layer.brd, WCSA_SystemSchem_4-Layer.brd]
2022-04-15 Updated OrCAD README details
    regarding linking PCB footprint files
2022-04-15 Routed most of 2-layer PCB layout (rough draft)
    [WCSA_SystemSchem_2-Layer.brd]
2022-04-17 Finished first draft of 4-layer PCB layout
    [WCSA_SYSTEMSCHEM.DSN, WCSA_SystemSchem.opj, WCSA_SystemSchem_4-Layer.brd, to_-102a2020-s_phr.psm]
2022-04-17 Fixed pin-numbering mismatch on trimpot. Added bypass cap to audio amp. Updated netlist + 4layer layout
    [WCSA_SYSTEMSCHEM.DSN, WCSA_SystemSchem.opj, WCSA_SystemSchem_4-Layer.brd, to_-102a2020-s_phr.psm]
2022-04-19 Pushing 2-layer .brd updates made by Evan
    [WCSA_SystemSchem_2-Layer.brd]
2022-04-21 Added PDFs of system schematic into WCSA_OrCAD folder
2022-04-21 2layer updates during VC
    [WCSA_SystemSchem_2-Layer.brd]
2022-04-21 Fixed netlisting issues with 2layer .brd file
    [MCU_POWER_BUTTON.DSN, MCU_Power_Button.opj, WCSA_SYSTEMSCHEM.DSN, WCSA_SystemSchem.opj, WCSA_SystemSchem_2-Layer.brd]
2022-04-21 Added schematic pdf of power subsystem PSPICE simulations
    [3dCaneRev1.05.SLDPRT, CaneWithClamps.SLDASM, HoseClamp.SLDPRT, Housing_Rev0.5.SLDPRT, POWERSYSTEM_SIMULATIONS.DSN, PowerSystem_Simulations.opj, WCSA_SYSTEMSCHEM.DSN, WCSA_SystemSchem.opj]
2022-04-21 Fixed PMOS orientation in Power subsystem PSPICE schematic pdf
    [POWERSYSTEM_SIMULATIONS.DSN, PowerSystem_Simulations.opj]
2022-04-22 up to date???
    [PowerSystem_Simulations.opj, WCSA_SystemSchem.opj]
2022-04-22 Swapped PCB footprint for 170uH inductor
    [WCSA_SystemSchem_2-Layer.brd, ind_smt_do3316p_12p95x9p4_coc.psm]
2022-04-22 Updated Evan's completed version of 2layer PCB layout
    [WCSA_SystemSchem_2-Layer.brd]
2022-04-22 Updated netlist for 4layer layout & placed new inductor. Still need to reroute traces accordingly
    [WCSA_SystemSchem_4-Layer.brd]
2022-04-22 Added Gerber files used for M60 milling 2layer PCB
    [art_param.txt, nc_param.txt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]
2022-04-27 Fixed glitches in FRT / tmr0 libs - for reference pre overhaul
    [WCSA_SystemSchem.opj]
2022-04-28 2-layer board revision 1.1
    [WCSA_SystemSchem_2-Layer.brd]
2022-04-28 Updated for ADC pin inclusion
    [WCSA_SYSTEMSCHEM.DSN, WCSA_SystemSchem.opj]
2022-04-28 Updated 4-layer PCB layout for larger L1 footprint, extra pair of resistors, and ADC pin connection for battery monitoring
    [WCSA_SYSTEMSCHEM.DSN, WCSA_SystemSchem.opj, WCSA_SystemSchem_4-Layer.brd]
2022-04-28 Cleaned up minor routing issues on 4layer PCB + added to-do note as layout text
    [WCSA_SystemSchem_4-Layer.brd]
2022-05-03 Fixed pinout of PMIC symbol in Capture project. Made necessary subcircuit changes, created new netlist, and imported to 4-layer .brd
    [WCSA_SYSTEMSCHEM.DSN, WCSA_SystemSchem.opj, WCSA_SystemSchem_4-Layer.brd]
2022-05-03 4-layer board routing
    [WCSA_SystemSchem.opj, WCSA_SystemSchem_4-Layer.brd]
2022-05-03 Fixed netlist surrounding PMIC (final correction) & did minor cleaning on 4layer PCB layout
    [WCSA_SYSTEMSCHEM.DSN, WCSA_SystemSchem.opj, WCSA_SystemSchem_4-Layer.brd]
2022-05-04 4-layer board silkscreen edits
    [WCSA_SystemSchem.opj, WCSA_SystemSchem_4-Layer.brd, art_param.txt, nc_param.txt]
2022-05-05 4-layer board art files
    [WCSA_SystemSchem_4-Layer.GBL, WCSA_SystemSchem_4-Layer.GBO, WCSA_SystemSchem_4-Layer.GBS, WCSA_SystemSchem_4-Layer.GKO, WCSA_SystemSchem_4-Layer.GTL, WCSA_SystemSchem_4-Layer.GTO, WCSA_SystemSchem_4-Layer.GTS, WCSA_SystemSchem_4-Layer.XLN]
2022-05-05 4-layer crosssection edits
    [WCSA_SystemSchem_4-Layer.brd, nc_param.txt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]
2022-05-05 positive layers & moved via
    [WCSA_SystemSchem_4-Layer.brd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]
2022-05-06 Completed 4-layer PCB layout + placed order from JLC using the 'WCSA_JLC.zip' included inside the \Gerbers folder
    [WCSA.GBL, WCSA.GBO, WCSA.GBS, WCSA.GKO, WCSA.GTL, WCSA.GTO, WCSA.GTS, WCSA_SystemSchem_4-Layer-1-4.drl]
2022-05-08 Still have not tested on MCU, but peripheral libraries have been condensed / combined / edited & are properly building simple test files
    [WCSA.XLN]
2022-05-08 Timers working properly (FRT), but cannot figure out how to work ADC testing yet
2022-05-08 Fixed ADC library & added a conditional test harness. All is working with ADC now.
    [FRT.c, adc.c]
2022-05-08 Added getCurrReading function to ADC library + added cleaner commenting conventions to existing .c files
2022-05-08 Combined contents of tmr2 & pwm5 into MotorControl library. Combined contents of tmr3 & ccp4 into SpeakerTone library.
2022-05-08 Resolved all #include errors
    [MotorControl.c, MotorControl.h, SpeakerTone.c, SpeakerTone.h, mcc.h]
2022-05-09 Combined mcc peripheral libraries directly into implementation / API libraries. E.g. [BatteryMonitor contains ADC], [FRT contains TMR1], [SpeakerTone contains CCP4 & TMR3], [MotorControl contains PWM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
2022-05-09 Updated WDT reset asm() commands with a #defined macro, RESET_WDT()
    [FRT.c, Lidar_Sensor.c, MotorControl.c, SpeakerTone.c, WCSA_system.h]
2022-05-09 Added private ADCBuffer functions into BatteryMonitor lib & updated test harness appropriately. Confirmed reduced noise on adc readings
    [WCSA_system.c]
2022-05-10 Added Startup/Shutdown chirp functions within SpeakerTone lib. Updated SpeakerTone & BatteryMonitor test harnesses to utilize these functions
2022-05-11 First complete draft of PowerButton.c + began Main Application
2022-05-12 SpeakerTone library & all functions are FINALLY working again! (it was an issue with syncing TMR3 - output compare occurring twice in a row & never holding the pin high)
    [SpeakerTone.c, WCSA_system.c, device_config.c, interrupt_manager.c]
2022-05-12 Updated WCSA_MainApp for forced-shutdown-conditions demonstration + fixed SpeakerTone chirp functions' timing
    [SpeakerTone.c, WCSA_MainApp.c, WCSA_system.c, interrupt_manager.c]
2022-05-12 Added additional chirp functions for LowBattery & Charging chirps
2022-05-13 Added images of manufactured PCB to JLCBoardPics folder
2022-05-19 Post-lab testing
    [WCSA_SystemSchem.opj]
2022-05-21 Main Application is working (first draft prototype verification)
2022-05-22 Motor intensity corresponds to hazard distance. Everything works as is. Need to add charge status & low-battery warning chirps
2022-05-22 Updated MainApp to include all battery state change warning chirps
2022-05-23 Updated MainApp comments + fixed diode orientation in Capture schematic
    [WCSA_SYSTEMSCHEM.DSN, WCSA_SystemSchem.opj, WCSA_SystemSchem_4-Layer.brd]
2022-05-25 First draft at PMIC implementation. Seem to always play ChargeCompleteChirp whenever plugging in charging voltage?
2022-05-25 Kenan's house testing - (just in case) push
2022-05-29 Rev1.0 final push - current bugs include: (excessive chirps for changing battery states, LiDAR constantly producing warnings under ambient sunlight)
    [MainApplication.c]
2022-05-29 Updated MainApplication.c should prevent excessive batLvl warnings
    [MainApplication.c]
2022-05-30 Rev 1.1.2 - only changed calculation for motor intensity (should be 6% DC @1.5m and 100% DC @9cm)
2022-05-31 Recloned, added new directories, need to clear copies
    [3dCaneRev1.05.SLDPRT, CaneWithClamps.SLDASM, HoseClamp.SLDPRT, Housing_Rev0.5.SLDPRT, MC33063A-Q1D_TRANS.OLB, MC33063A-Q1_TRANS.OPJ, MCU_POWER_BUTTON.DSN, MCU_Power_Button.opj]
2022-05-31 Reorganized repo directory structure + began drafting homepage readme.md
    [3dCaneRev1.05.SLDPRT, CaneWithClamps.SLDASM, HoseClamp.SLDPRT, Housing_Rev0.5.SLDPRT, MC33063A-Q1D_TRANS.OLB, MC33063A-Q1_TRANS.OPJ, MCU_POWER_BUTTON.DSN, MCU_Power_Button.opj]
2022-05-31 Updated with current Housing design SolidWorks files
    [HousingBox_V5.0.SLDPRT, LidSmSpeaker_V5.0.SLDPRT]
2022-06-02 Changed motor thresholds - warning distance = 1.75m; minimum vibration time = 200ms
    [MainApplication.c, SpeakerTone.c]
